shredermann-hash/MoodiMOS/english/cad/MoodiMOS_Robot/screens/face.png

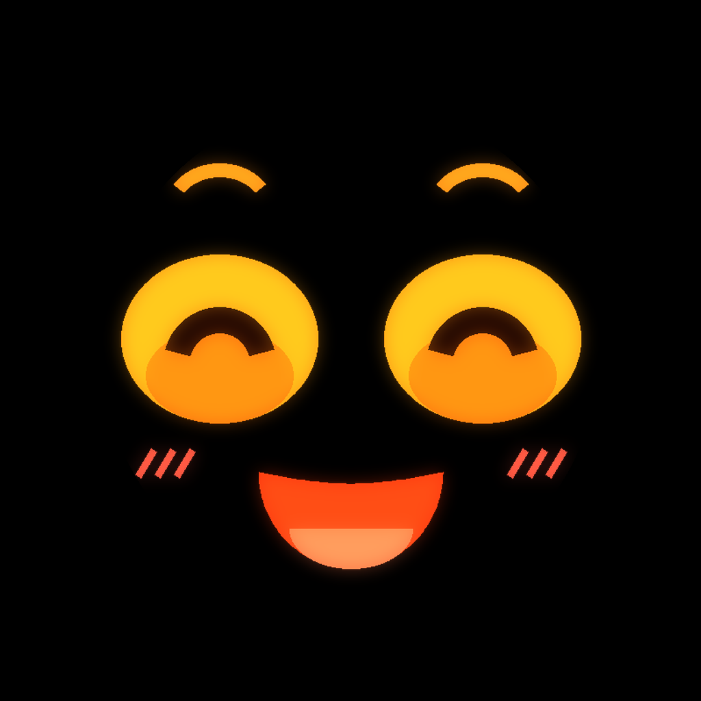
english/cad/MoodiMOS_Robot/screens/face.png
