shredermann-hash/MoodiMOS/english/cad/MoodiMOS_Robot/screens/torso.png

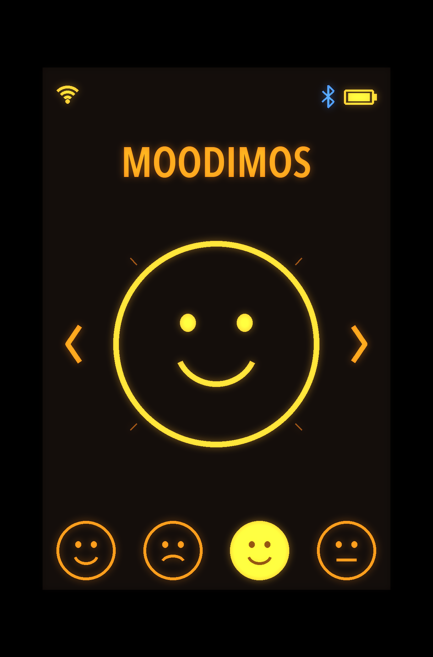
english/cad/MoodiMOS_Robot/screens/torso.png
