shredermann-hash/MoodiMOS/english/extras/dashboard.png

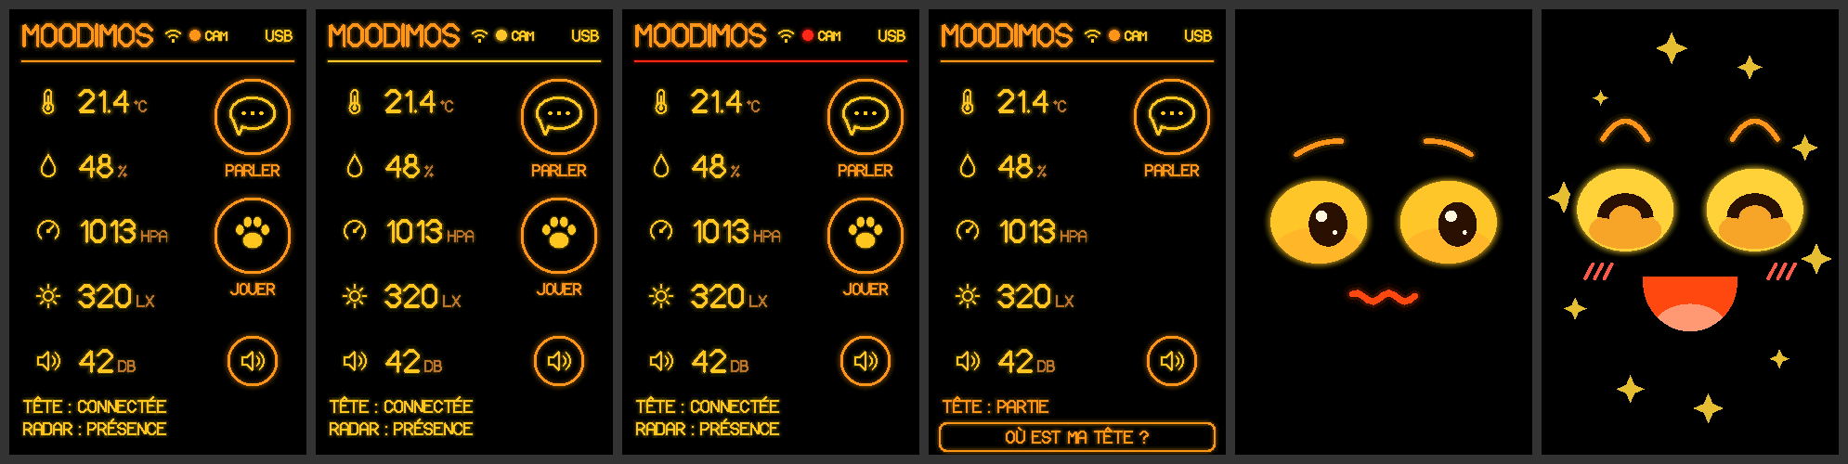
english/extras/dashboard.png
