shredermann-hash/MoodiMOS/english/extras/dial.png

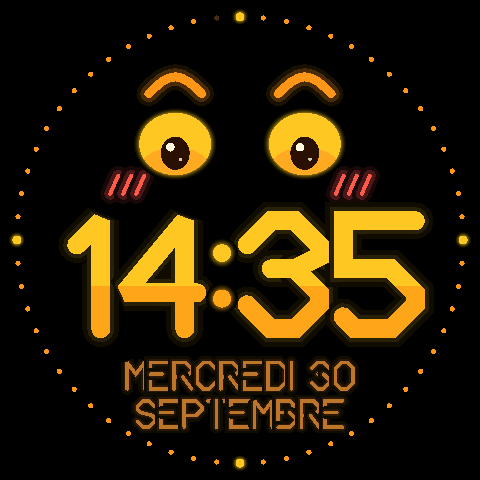
english/extras/dial.png
