shredermann-hash/MoodiMOS/english/extras/neon_face.png

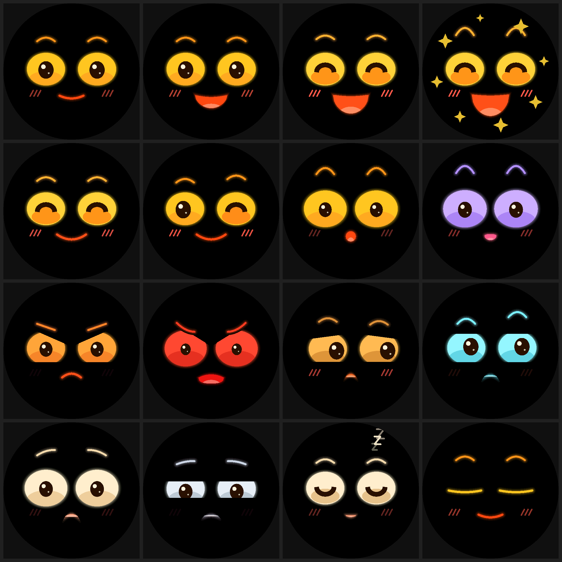
english/extras/neon_face.png
