shredermann-hash/MoodiMOS/english/extras/timer.png

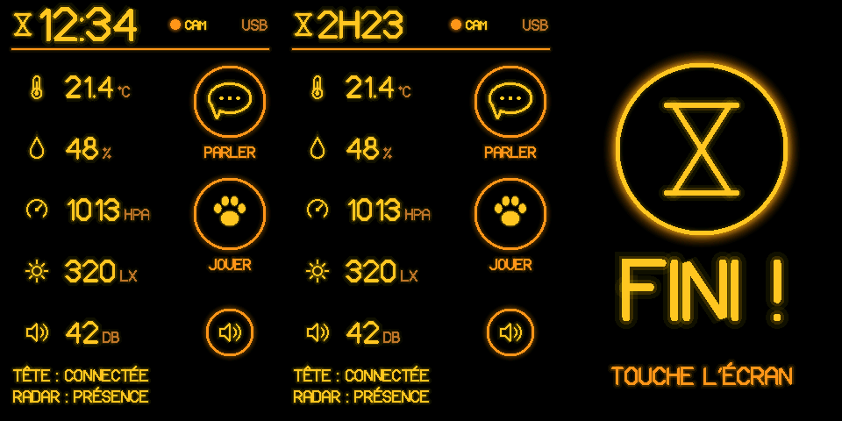
english/extras/timer.png
