shredermann-hash/MoodiMOS/english/extras/who_is_speaking.png

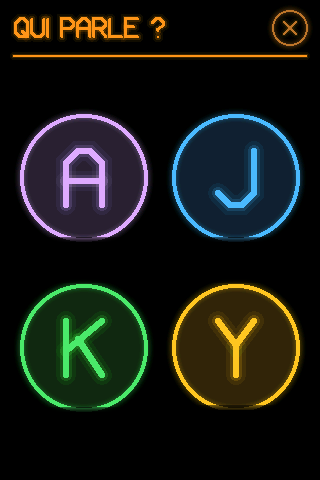
english/extras/who_is_speaking.png
