shredermann-hash/MoodiMOS/english/illustrations/design_head.png

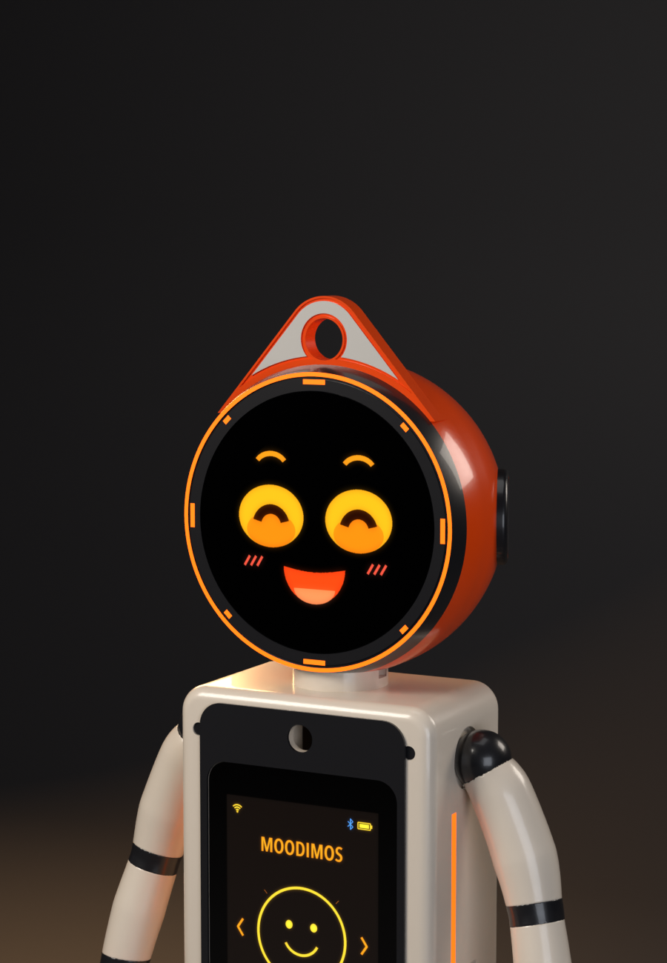
english/illustrations/design_head.png
