shredermann-hash/MoodiMOS/english/illustrations/preview_en_clock.png

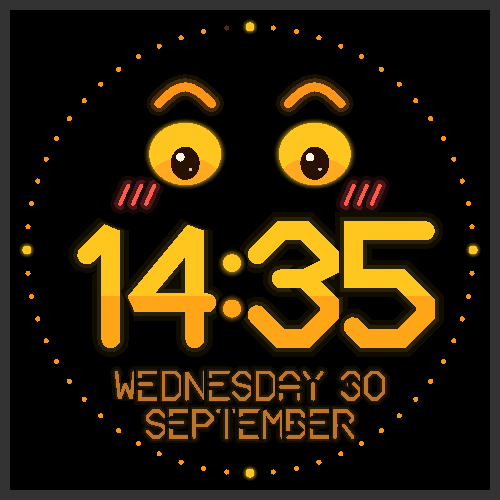
english/illustrations/preview_en_clock.png
