shredermann-hash/MoodiMOS/english/illustrations/preview_en_torso.png

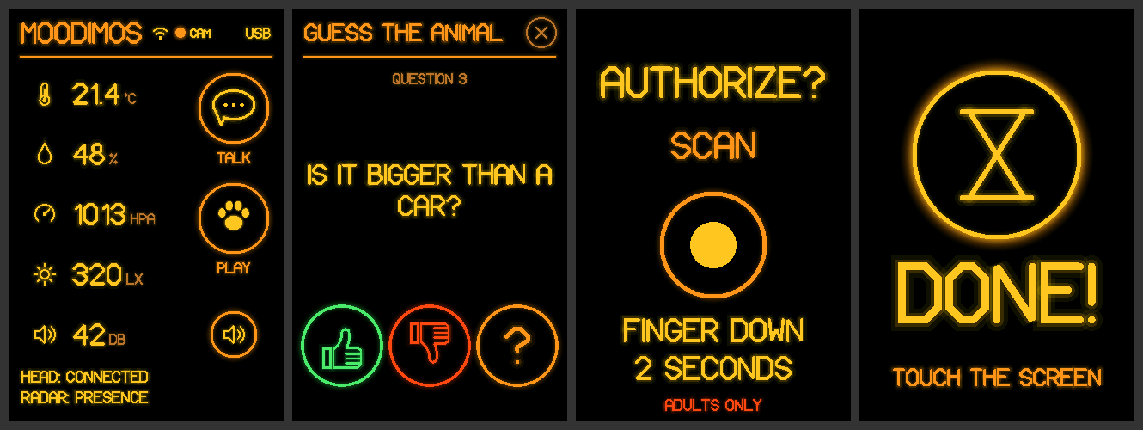
english/illustrations/preview_en_torso.png
