shredermann-hash/MoodiMOS/english/cad/MoodiMOS_Organic/print_stl/pogo_gauge.stl

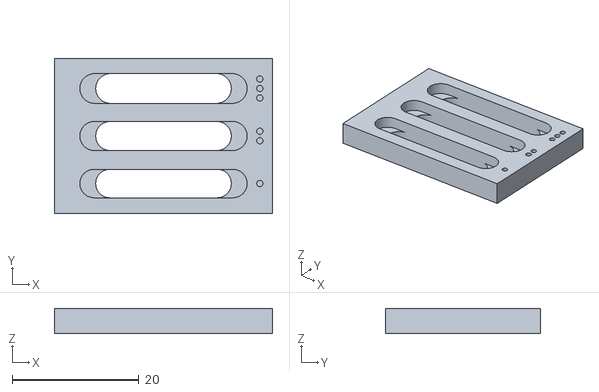
[picture p12: CAD file, 2026-11-03]
english/cad/MoodiMOS_Organic/print_stl/pogo_gauge.stl
34.4 x 24.5 x 4.00
