shredermann-hash/MoodiMOS/english/cad/MoodiMOS_Robot/print_stl/bezel_side_mask.stl

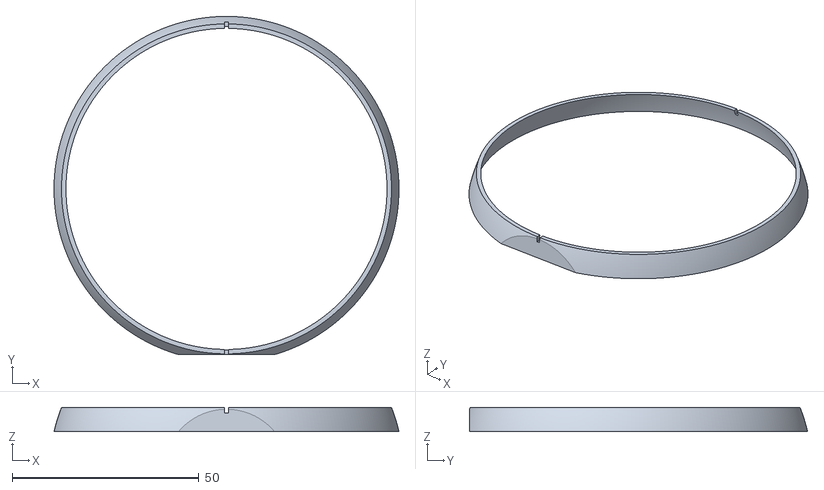
[picture p13: CAD file, 2026-11-03]
english/cad/MoodiMOS_Robot/print_stl/bezel_side_mask.stl
92.4 x 90.6 x 6.50
