shredermann-hash/MoodiMOS/francais/cao/MoodiMOS_Robot/stl_impression/pochoir_index_lunette.stl

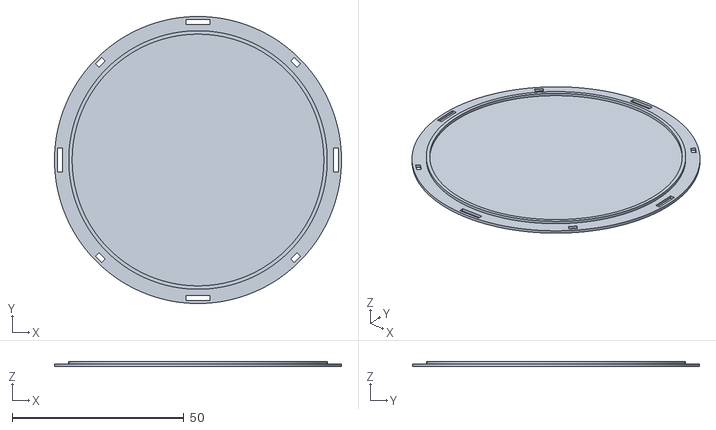
[picture p14: CAD file, 2026-11-03]
francais/cao/MoodiMOS_Robot/stl_impression/pochoir_index_lunette.stl
83.6 x 83.6 x 1.60
