shredermann-hash/MoodiMOS/english/cad/MoodiMOS_Robot/print_stl/glove_cuff_left.stl

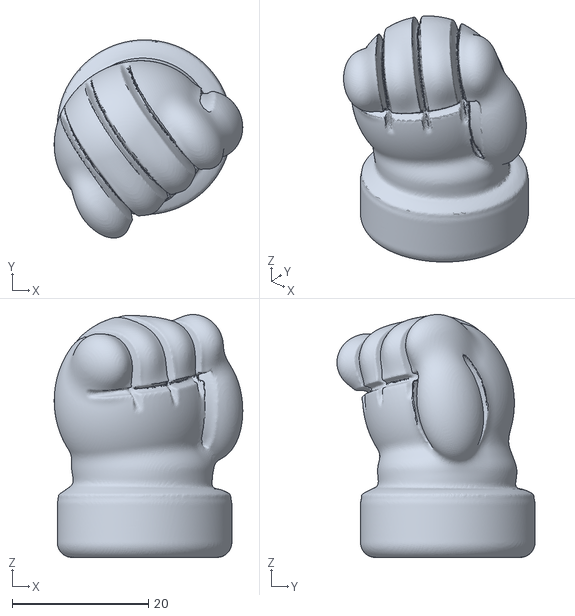
[picture p15: CAD file, 2026-11-03]
english/cad/MoodiMOS_Robot/print_stl/glove_cuff_left.stl
27.6 x 29.0 x 35.6
