shredermann-hash/MoodiMOS/francais/cao/MoodiMOS_Robot/stl_impression/bras_gauche.stl

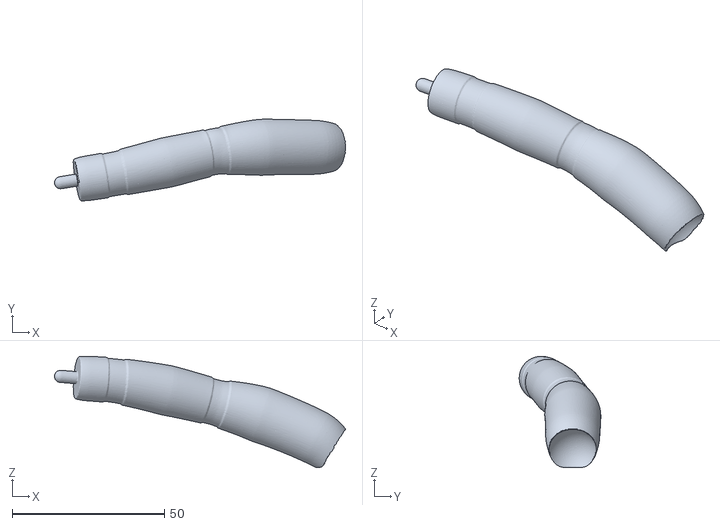
[picture p16: CAD file, 2026-11-03]
francais/cao/MoodiMOS_Robot/stl_impression/bras_gauche.stl
95.7 x 26.8 x 36.6
