shredermann-hash/MoodiMOS/english/cad/MoodiMOS_Robot/print_stl/base.stl

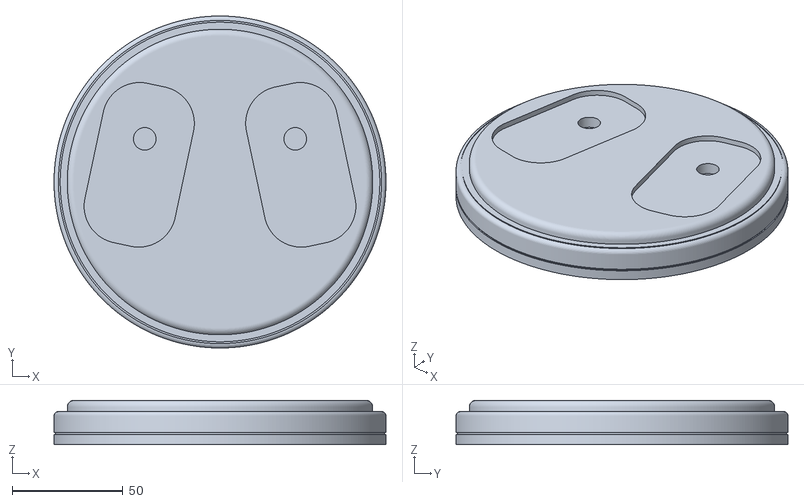
[picture p17: CAD file, 2026-11-03]
english/cad/MoodiMOS_Robot/print_stl/base.stl
150.0 x 150.0 x 20.0
