shredermann-hash/MoodiMOS/francais/cao/MoodiMOS_Robot/stl_impression/torse_cadre.stl

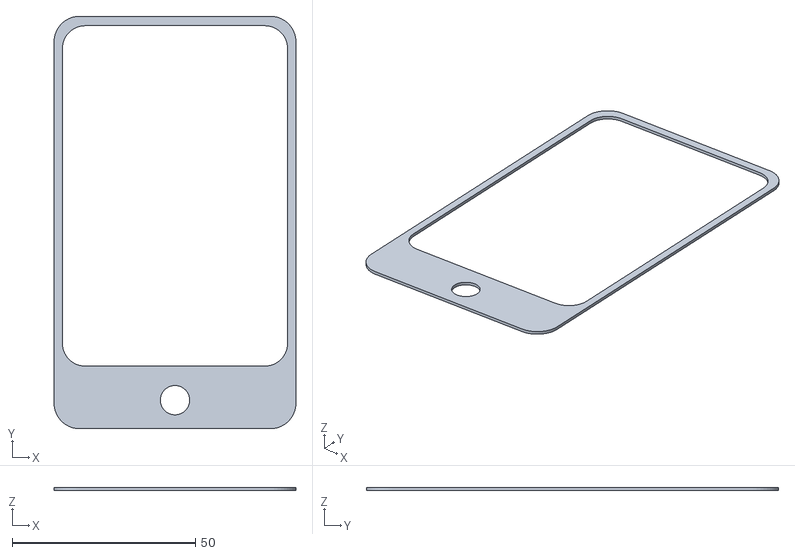
[picture p18: CAD file, 2026-11-03]
francais/cao/MoodiMOS_Robot/stl_impression/torse_cadre.stl
66.0 x 112.5 x 0.85
