shredermann-hash/MoodiMOS/english/cad/MoodiMOS_Robot/print_stl/torso_speaker_box.stl

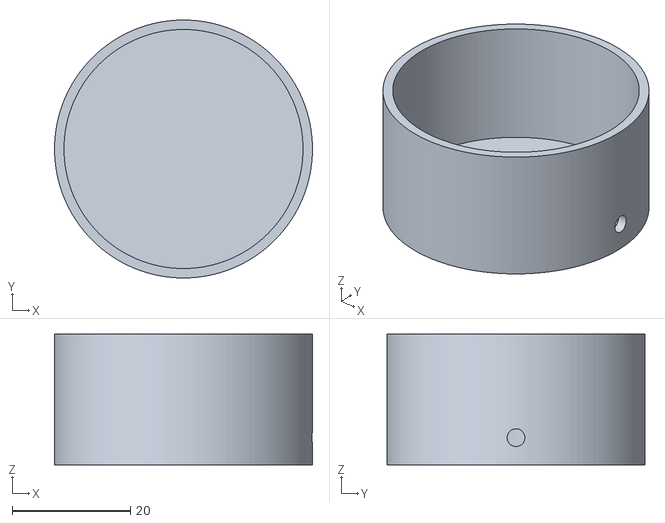
[picture p19: CAD file, 2026-11-03]
english/cad/MoodiMOS_Robot/print_stl/torso_speaker_box.stl
43.6 x 43.6 x 22.1
