shredermann-hash/MoodiMOS/english/cad/MoodiMOS_Robot/print_stl/torso_back.stl

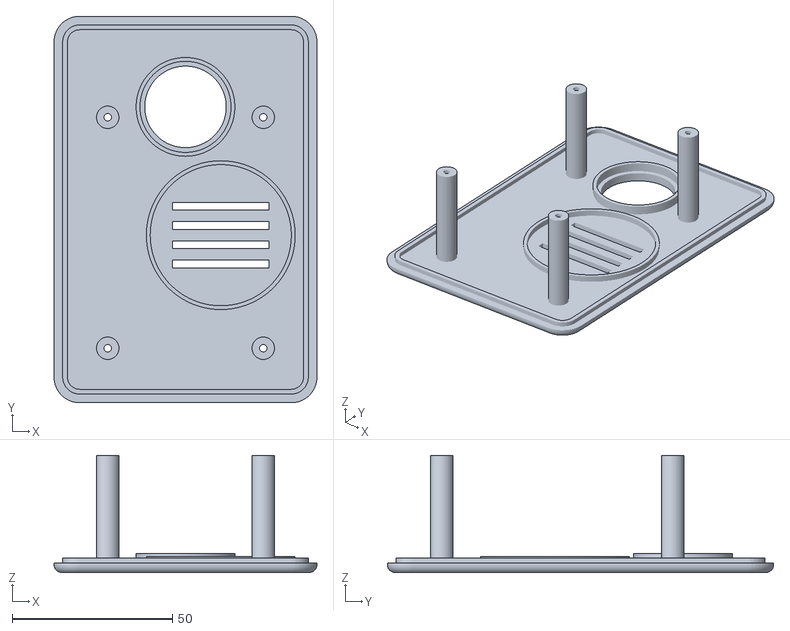
[picture p20: CAD file, 2026-11-03]
english/cad/MoodiMOS_Robot/print_stl/torso_back.stl
82.0 x 120.5 x 36.5
