shredermann-hash/MoodiMOS/francais/cao/MoodiMOS_Robot/stl_impression/epaule_gauche.stl

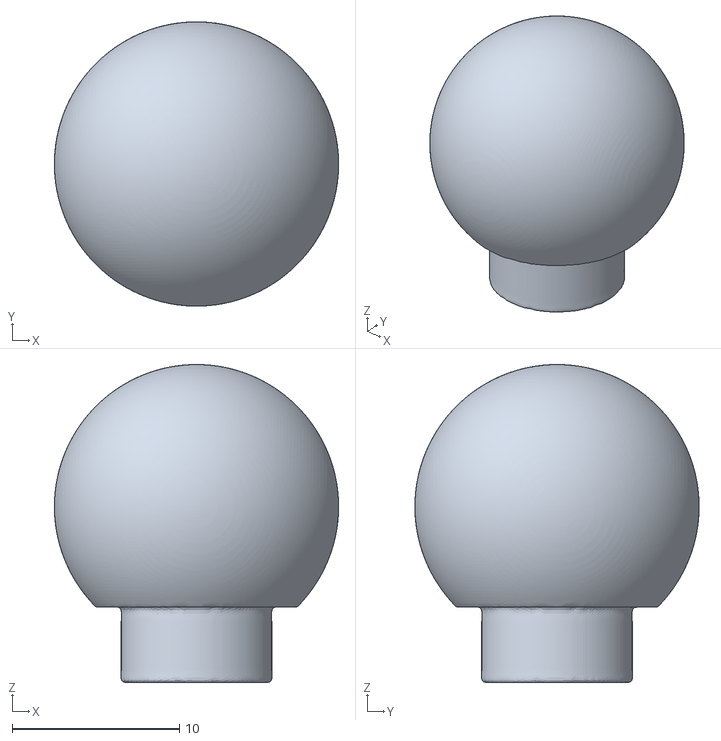
[picture p21: CAD file, 2026-11-03]
francais/cao/MoodiMOS_Robot/stl_impression/epaule_gauche.stl
17.0 x 17.0 x 19.0
