shredermann-hash/MoodiMOS/english/cad/MoodiMOS_Robot/print_stl/torso_front.stl

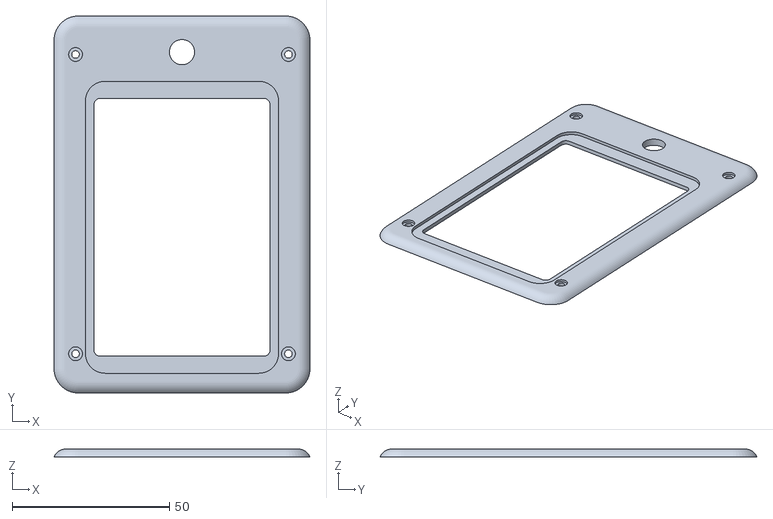
[picture p22: CAD file, 2026-11-03]
english/cad/MoodiMOS_Robot/print_stl/torso_front.stl
81.4 x 119.9 x 2.50
