shredermann-hash/MoodiMOS/francais/cao/MoodiMOS_Robot/stl_impression/tete_dos.stl

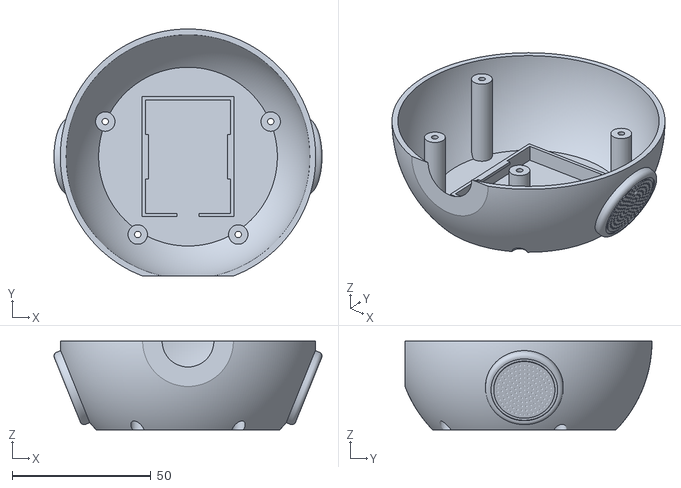
[picture p23: CAD file, 2026-11-03]
francais/cao/MoodiMOS_Robot/stl_impression/tete_dos.stl
96.6 x 89.0 x 32.0
