shredermann-hash/MoodiMOS/francais/cao/MoodiMOS_Robot/stl_impression/tete_plaque.stl

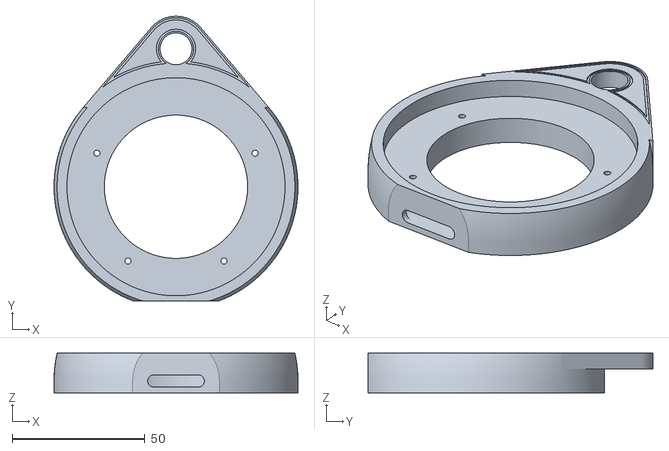
[picture p24: CAD file, 2026-11-03]
francais/cao/MoodiMOS_Robot/stl_impression/tete_plaque.stl
92.0 x 107.3 x 15.0
