shredermann-hash/MoodiMOS/english/cad/MoodiMOS_Robot/print_stl/head_bezel.stl

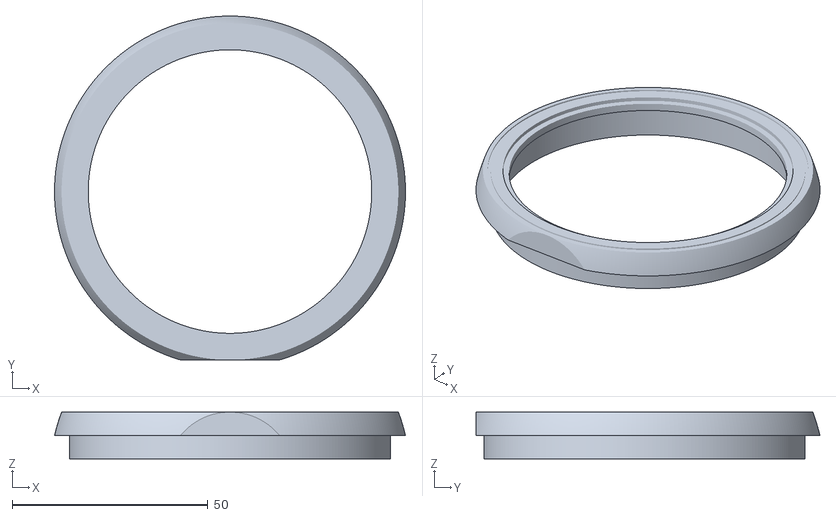
[picture p25: CAD file, 2026-11-03]
english/cad/MoodiMOS_Robot/print_stl/head_bezel.stl
89.6 x 87.8 x 12.0
