shredermann-hash/MoodiMOS/francais/cao/MoodiMOS_Robot/stl_impression/basket_gauche.stl

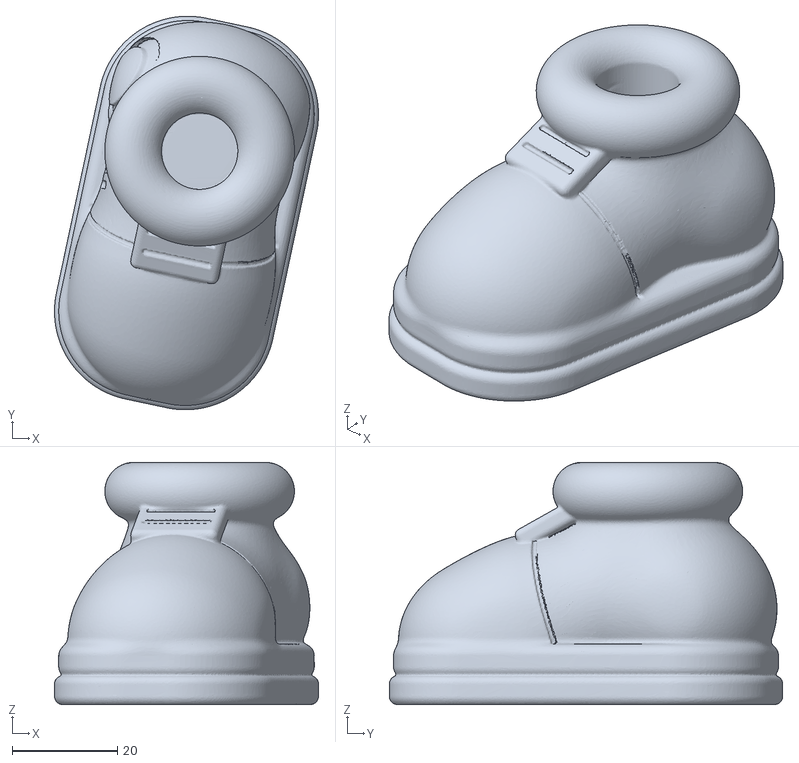
[picture p26: CAD file, 2026-11-03]
francais/cao/MoodiMOS_Robot/stl_impression/basket_gauche.stl
50.1 x 74.7 x 46.0
