shredermann-hash/MoodiMOS/francais/cao/MoodiMOS_Robot/stl_impression/torse_coque.stl

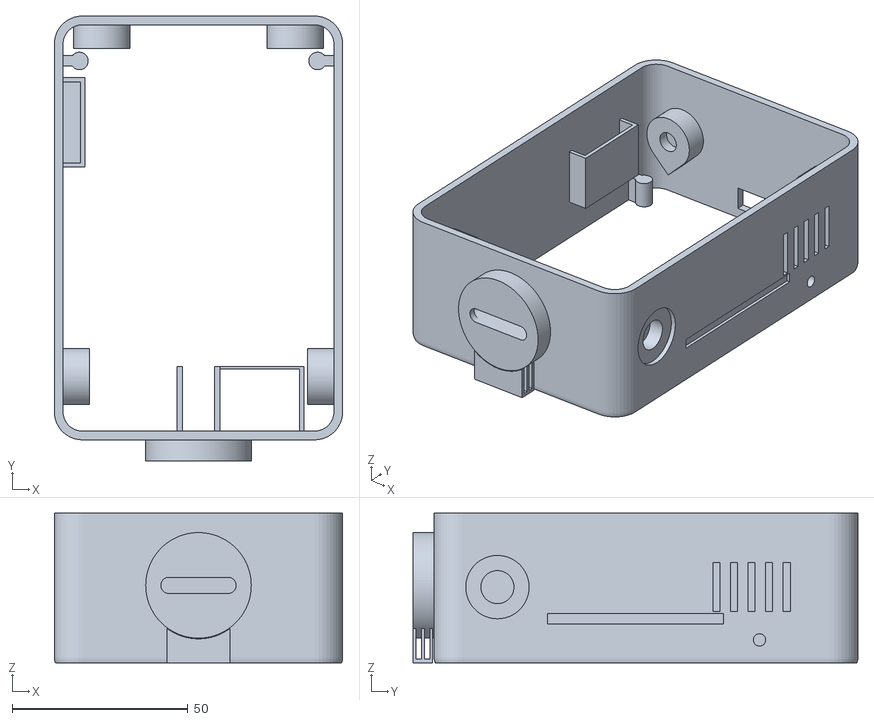
[picture p27: CAD file, 2026-11-03]
francais/cao/MoodiMOS_Robot/stl_impression/torse_coque.stl
82.0 x 126.5 x 42.5
