shredermann-hash/MoodiMOS/english/cad/MoodiMOS_Robot/print_stl/sneaker_magnet_jig_left.stl

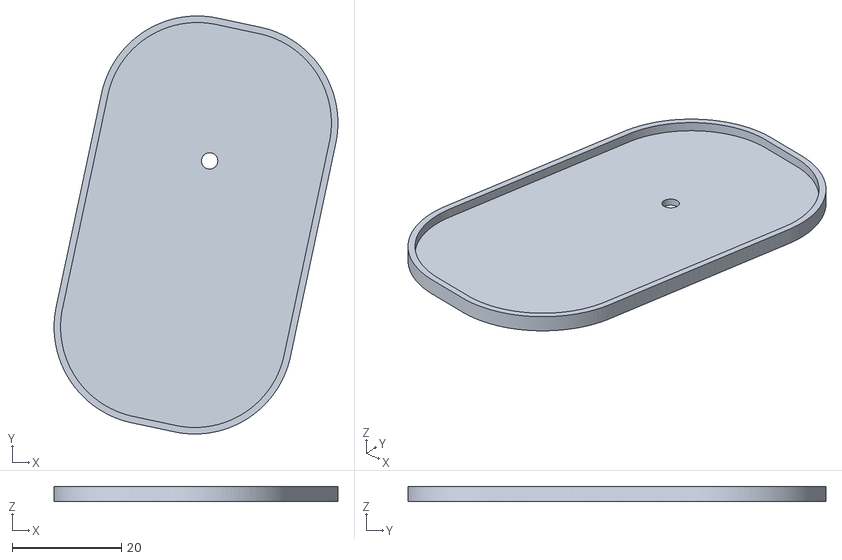
[picture p28: CAD file, 2026-11-03]
english/cad/MoodiMOS_Robot/print_stl/sneaker_magnet_jig_left.stl
52.0 x 76.6 x 2.80
