shredermann-hash/MoodiMOS/francais/cao/MoodiMOS_Robot/stl_impression/jambe_droit.stl

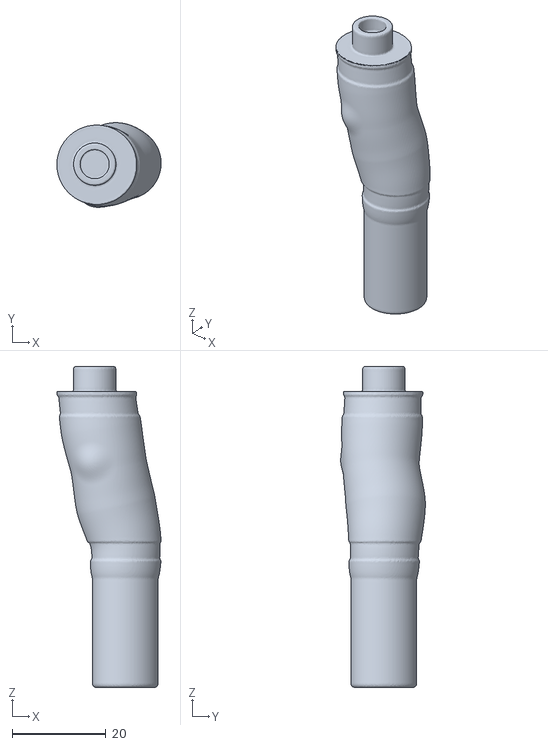
[picture p29: CAD file, 2026-11-03]
francais/cao/MoodiMOS_Robot/stl_impression/jambe_droit.stl
22.2 x 18.0 x 68.4
