shredermann-hash/MoodiMOS/(list of files, cad)

Other CAD files:
english/cad/MoodiMOS_Robot/print_stl/arm_right.stl
english/cad/MoodiMOS_Robot/print_stl/sneaker_right.stl
francais/cao/MoodiMOS_Robot/stl_impression/basket_droit.stl
francais/cao/MoodiMOS_Robot/stl_impression/gabarit_aimant_basket_gauche.stl
francais/cao/MoodiMOS_Robot/stl_impression/socle.stl
francais/cao/MoodiMOS_Robot/stl_impression/jambe_gauche.stl
english/cad/MoodiMOS_Robot/print_stl/glove_cuff_right.stl
francais/cao/MoodiMOS_Robot/stl_impression/epaule_droit.stl
english/cad/MoodiMOS_Robot/print_stl/leg_left.stl
francais/cao/MoodiMOS_Robot/stl_impression/gabarit_aimant_basket_droit.stl
english/cad/MoodiMOS_Robot/print_stl/shoulder_right.stl
francais/cao/MoodiMOS_Robot/stl_impression/bras_droit.stl
english/cad/MoodiMOS_Robot/print_stl/sneaker_magnet_jig_right.stl
francais/cao/MoodiMOS_Robot/stl_impression/gant_bracelet_droit.stl
