shredermann-hash/MoodiMOS/english/diagrams/MoodiMOS_Wiring_neck_pogo.png

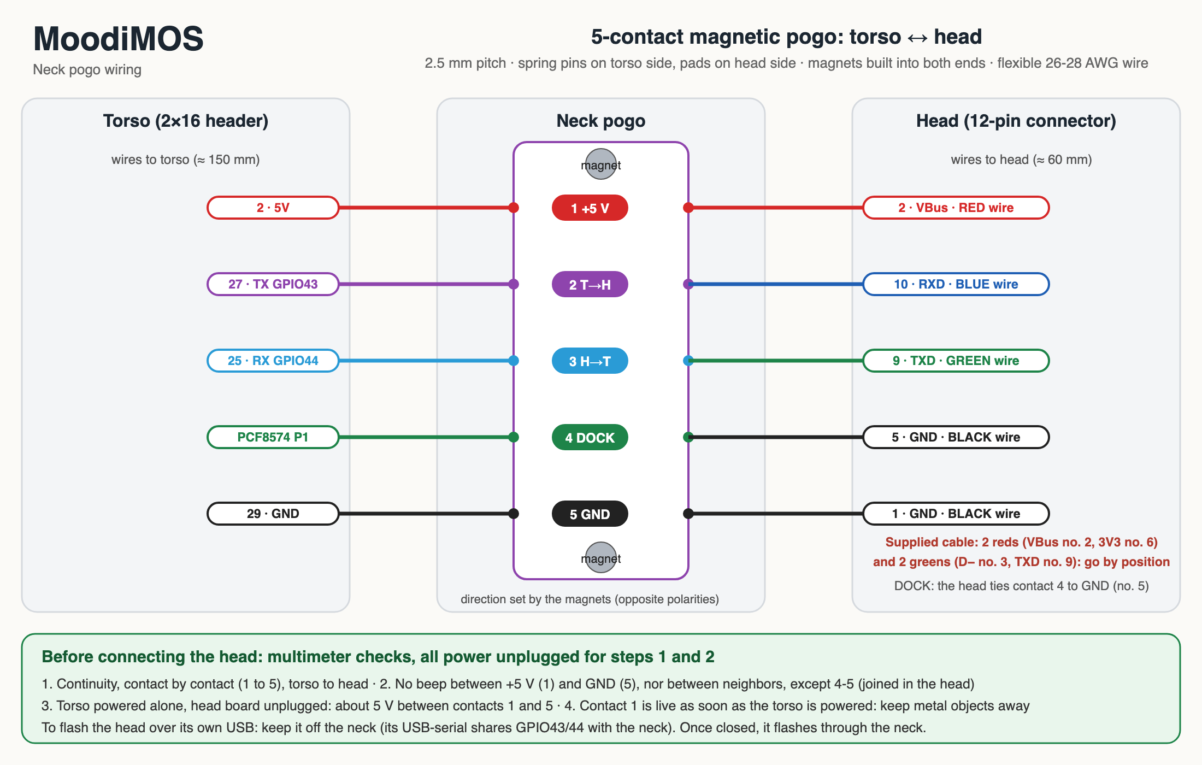
english/diagrams/MoodiMOS_Wiring_neck_pogo.png
