shredermann-hash/MoodiMOS/english/diagrams/MoodiMOS_Wiring_torso_head.png

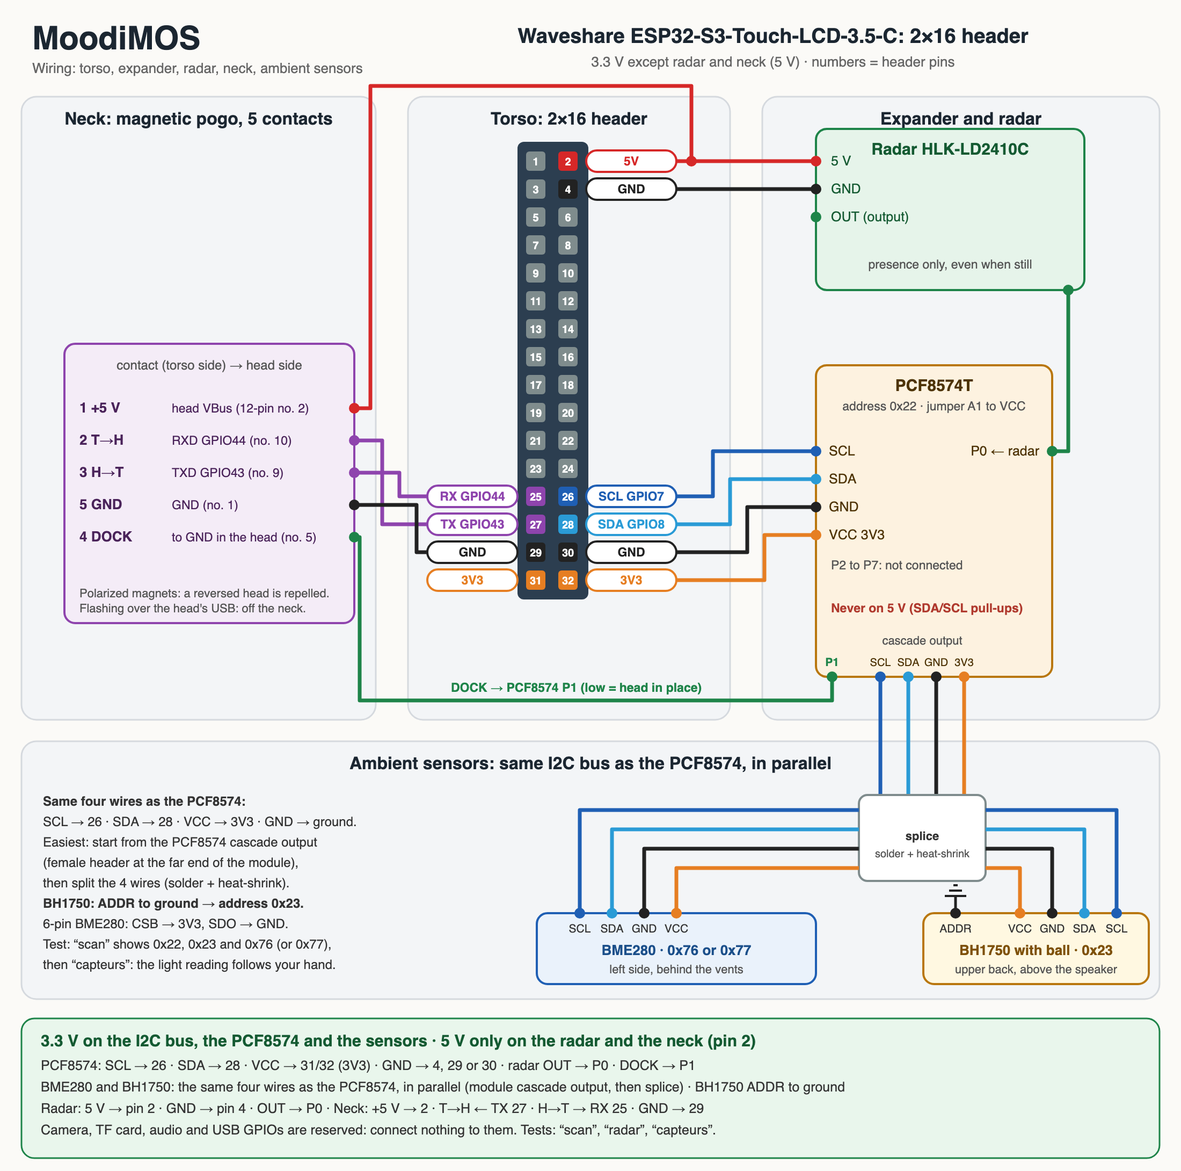
english/diagrams/MoodiMOS_Wiring_torso_head.png
