shredermann-hash/MoodiMOS/english/firmware/moodimos-torso/GuessGame.h

// "Guess the Animal" (complete edition): the child thinks of an animal; the robot guesses by asking questions, responding via the torso screen buttons (yes, no, I don’t know). Pure logic, tested on computer (tests/guess_tests.cpp): the torso loop generates phrases, triggers head expressions, and renders the screen based on outputs.
// 
// GuessEngine: the prototype logic (Mac, extras/guess_animal/guess_animal.py), same probabilities—each response reinforces matching animals without eliminating others (wrong answers don’t invalidate the game). The next question optimally narrows remaining candidates.
// 
// GuessGame: the game mode. Phrases stored in torso flash (devine_intro, devine_q07, devine_a12…), generated by extras/guess_animal/to_robot.py.
#pragma once
#include <math.h>
#include <stdint.h>
#include <stdio.h>
#include <string.h>
#include "GuessData.h"
#include "HeadExpressions.h"

class GuessEngine {
 public:
  enum Answer : uint8_t { YES, NO, DONT_KNOW };
  struct Move { bool propose; uint8_t index; };   // Proposed animal query
  static constexpr double RELIABLE = 0.9;      // a child responds 9 times out of 10
  static constexpr double SURE = 0.8, AHEAD = 8.0;   // proposes a safer design, ahead of the second option.
  static constexpr int MIN_QUESTIONS = 3, MAX_QUESTIONS = 14;

  void start() {
    for (double& p : p_) p = 1.0 / GuessData::ANIMALS;
    asked_ = rejected_ = 0;
    count_ = 0;
  }

  Move next() const {
    int fav = 0;
    for (int i = 1; i < GuessData::ANIMALS; i++)
      if (p_[i] > p_[fav]) fav = i;
    double second = 0;   // second highest probability (equal to the first in case of a tie)
    for (int i = 0; i < GuessData::ANIMALS; i++)
      if (i != fav && p_[i] > second) second = p_[i];
    const int q = bestQuestion();
    const bool ahead = p_[fav] >= SURE || p_[fav] >= AHEAD * second;   // an inconsistent answer should not leave the game looping
    if (q < 0 || count_ >= MAX_QUESTIONS || (ahead && count_ >= MIN_QUESTIONS)) return {true, uint8_t(fav)};
    return {false, uint8_t(q)};
  }

  void answer(uint8_t q, Answer a) {
    if (q >= GuessData::QUESTIONS) return;
    asked_ |= 1ULL << q;
    count_++;
    if (a == DONT_KNOW) return;
    for (int i = 0; i < GuessData::ANIMALS; i++) {
      const double y = yesProb(i, q);
      p_[i] *= a == YES ? y : 1 - y;
    }
    normalize();
  }

  // The robot suggested this animal, which was not it.
  void reject(uint8_t animal) {
    if (animal >= GuessData::ANIMALS) return;
    rejected_ |= 1ULL << animal;
    p_[animal] = 0;
    normalize();
  }

  int asked() const { return count_; }
  double probability(uint8_t animal) const { return animal < GuessData::ANIMALS ? p_[animal] : 0; }

 private:
  // Probability child answers "yes" to question q while thinking of animal a.
  double yesProb(int a, int q) const {
    const GuessData::Animal& an = GuessData::ANIMAL[a];
    double v = an.yes >> q & 1 ? 1.0 : an.maybe >> q & 1 ? 0.5 : 0.0;
    if (GuessData::QUESTION[q].inverse) v = 1 - v;
    return RELIABLE * v + (1 - RELIABLE) * (1 - v);
  }

  static double entropy(const double* p, int n, double scale) {
    double h = 0;
    for (int i = 0; i < n; i++) {
      const double x = p[i] * scale;
      if (x > 0) h -= x * log2(x);
    }
    return h;
  }

  // Information gain maximum; −1 if no useful question remains.
  int bestQuestion() const {
    const int n = GuessData::ANIMALS;
    const double base = entropy(p_, n, 1);
    double gainMax = 0.02;
    int choice = -1;
    double yes[GuessData::ANIMALS], no[GuessData::ANIMALS];
    for (int q = 0; q < GuessData::QUESTIONS; q++) {
      if (asked_ >> q & 1) continue;
      double pYes = 0;
      for (int i = 0; i < n; i++) {
        yes[i] = p_[i] * yesProb(i, q);
        no[i] = p_[i] - yes[i];
        pYes += yes[i];
      }
      if (!(pYes > 0 && pYes < 1)) continue;
      const double gain = base - pYes * entropy(yes, n, 1 / pYes) - (1 - pYes) * entropy(no, n, 1 / (1 - pYes));
      if (gain > gainMax) { choice = q; gainMax = gain; }
    }
    return choice;
  }

  void normalize() {
    double s = 0;
    for (double p : p_) s += p;
    if (s <= 0) {   // No probable animals left: all those not excluded revert to possible.
      for (int i = 0; i < GuessData::ANIMALS; i++) s += p_[i] = rejected_ >> i & 1 ? 0 : 1;
      if (s <= 0) { start(); return; }
    }
    for (double& p : p_) p /= s;
  }

  double p_[GuessData::ANIMALS] = {};
  uint64_t asked_ = 0, rejected_ = 0;
  int count_ = 0;
};

class GuessGame {
 public:
  using Answer = GuessEngine::Answer;
  static constexpr int TRIES = 3;                  // Three animals proposed at most
  static constexpr uint32_t WAIT_MS = 15000;       // No response: question repeated.
  static constexpr int REPEATS = 2;                // He abandoned and sulked: she left the game unfinished.
  static constexpr uint32_t THINK_MS = 700;        // a brief pause between two questions
  static constexpr uint32_t SILENT_MS = 800;       // Unheard phrase (missing file): proceed.
  static constexpr uint32_t PRESSED_MS = 400;      // Button lit after pressing

  bool active() const { return st_ != St::Off; }
  // Active response buttons (otherwise shown as off)
  bool buttons() const { return st_ == St::Ask || st_ == St::Propose || st_ == St::Replay; }
  int8_t pressed(uint32_t now) const { return pressedAt_ && since(now, pressedAt_) < PRESSED_MS ? pressed_ : -1; }
  uint8_t round() const { return st_ == St::Ask || st_ == St::Pause ? uint8_t(engine_.asked() + (st_ == St::Ask)) : 0; }
  const char* text() const { return text_; }
  uint32_t revision() const { return revision_; }   // Change on every visible screen update.

  void start(uint32_t now) {
    engine_.start();
    tries_ = 0;
    pressedAt_ = doneAt_ = 0;   // nothing of the front section (a button left "pressed" for days later)
    say("devine_intro", St::Intro, now);
    show("PENSE TRÈS FORT À UN ANIMAL !");
  }

  void quit() {
    if (!active()) return;
    st_ = St::Off;
    stop_ = true;
    phrase_[0] = 0;
    revision_++;
  }

  void press(Answer a, uint32_t now) {
    if (!buttons()) return;
    pressed_ = int8_t(a);
    pressedAt_ = now | 1;
    revision_++;
    switch (st_) {
      case St::Ask:
        engine_.answer(question_, a);
        expression(HeadExpressions::PERPLEXE, 10);   // *reflects*
        stop_ = true;                                // The current question is incomplete.
        st_ = St::Pause;
        pauseUntil_ = now + THINK_MS;
        break;
      case St::Propose:
        if (a == Answer::YES) {
          expression(HeadExpressions::JOIE, 40);
          say("devine_youpi", St::Won, now);
          show("YOUPI ! J'AI DEVINÉ !");
        } else if (a == Answer::NO) {
          engine_.reject(animal_);
          if (tries_ < TRIES) {
            expression(HeadExpressions::SURPRIS, 15);
            say("devine_encore", St::Again, now);
            show("OH ! JE RÉFLÉCHIS ENCORE...");
          } else {
            expression(HeadExpressions::RIEUR, 40);
            say("devine_bravo", St::Lost, now);
            show("BRAVO, TU M'AS BATTU !");
          }
        } else {
          sayAgain(now);   // Uncertainty prompt: *"Is it a cat?"* → repeats query
        }
        break;
      case St::Replay:
        if (a == Answer::YES) {
          engine_.start();
          tries_ = 0;
          say("devine_go", St::Go, now);
          show("ON Y VA !");
        } else {
          bye(now);
        }
        break;
      default:
        break;
    }
  }

  void update(uint32_t now, bool speaking) {
    if (!active()) return;
    if (pressedAt_ && since(now, pressedAt_) >= PRESSED_MS) { pressedAt_ = 0; revision_++; }
    if (speaking) heard_ = true;
    const bool done = !phrase_[0] && ((heard_ && !speaking) || (!heard_ && since(now, saidAt_) >= SILENT_MS));
    if (done && !doneAt_) doneAt_ = now | 1;
    switch (st_) {
      case St::Intro:
        if (done) { say("devine_go", St::Go, now); show("ON Y VA !"); }
        break;
      case St::Go:
      case St::Again:
        if (done) move(now);
        break;
      case St::Pause:
        if (int32_t(now - pauseUntil_) >= 0) move(now);
        break;
      case St::Won:
      case St::Lost:
        if (done) { say("devine_rejoue", St::Replay, now); show("ON REJOUE ?"); }
        break;
      case St::Ask:
      case St::Propose:
      case St::Replay:
        if (doneAt_ && since(now, doneAt_) >= WAIT_MS) {
          if (st_ == St::Replay) bye(now);                 // Finished part, no response: goodbye
          else if (repeats_ >= REPEATS) abandon();         // unfinished section: sulks, silent
          else { repeats_++; sayAgain(now); }
        }
        break;
      case St::Bye:
        if (done) { st_ = St::Off; revision_++; }
        break;
      case St::Off:
        break;
    }
  }

  // What the loop should now perform (each request is returned only once).
  const char* takePhrase(char* out, size_t size) {
    if (!phrase_[0]) return nullptr;
    snprintf(out, size, "%s", phrase_);
    phrase_[0] = 0;
    return out;
  }
  bool takeStop() { bool s = stop_; stop_ = false; return s; }
  bool takeSulk() { bool s = sulk_; sulk_ = false; return s; }   // abandoned part: the head is sulking
  bool takeExpression(uint8_t& expr, uint8_t& tenths) {
    if (!exprPending_) return false;
    exprPending_ = false;
    expr = expr_;
    tenths = tenths_;
    return true;
  }

  const GuessEngine& engine() const { return engine_; }
  int tries() const { return tries_; }
  uint8_t question() const { return question_; }
  uint8_t animal() const { return animal_; }

 private:
  enum class St : uint8_t { Off, Intro, Go, Ask, Pause, Propose, Again, Won, Lost, Replay, Bye };

  // Elapsed time since t; 0 if t is a marked instant marked « | 1 » exactly in the future.
  static uint32_t since(uint32_t now, uint32_t t) { return int32_t(now - t) > 0 ? now - t : 0; }

  void say(const char* name, St next, uint32_t now) {
    snprintf(phrase_, sizeof(phrase_), "%s", name);
    st_ = next;
    saidAt_ = now;
    heard_ = false;
    doneAt_ = 0;
    revision_++;
  }

  void sayAgain(uint32_t now) {
    char name[sizeof(phrase_)];
    if (st_ == St::Ask) snprintf(name, sizeof(name), "devine_q%02d", question_);
    else if (st_ == St::Propose) snprintf(name, sizeof(name), "devine_a%02d", animal_);
    else snprintf(name, sizeof(name), "devine_rejoue");
    say(name, st_, now);
  }

  void move(uint32_t now) {
    const GuessEngine::Move m = engine_.next();
    char name[sizeof(phrase_)];
    repeats_ = 0;
    if (m.propose) {
      tries_++;
      animal_ = m.index;
      snprintf(name, sizeof(name), "devine_a%02d", animal_);
      expression(HeadExpressions::CONTENT, 20);   // not EMBALLE: on the head, that is the red anger
      say(name, St::Propose, now);
      snprintf(text_, sizeof(text_), "C'EST %s ?", GuessData::ANIMAL[animal_].name);
    } else {
      question_ = m.index;
      snprintf(name, sizeof(name), "devine_q%02d", question_);
      expression(HeadExpressions::CURIEUX, 30);
      say(name, St::Ask, now);
      show(GuessData::QUESTION[question_].text);
    }
  }

  void bye(uint32_t now) {
    expression(HeadExpressions::CLIN, 20);
    say("devine_bientot", St::Bye, now);
    show("À BIENTÔT !");
  }

  void abandon() {
    st_ = St::Off;
    sulk_ = true;
    revision_++;
  }

  void show(const char* s) { snprintf(text_, sizeof(text_), "%s", s); }
  void expression(uint8_t e, uint8_t tenths) { expr_ = e; tenths_ = tenths; exprPending_ = true; }

  GuessEngine engine_;
  St st_ = St::Off;
  char phrase_[16] = {};
  char text_[96] = {};
  uint32_t saidAt_ = 0, doneAt_ = 0, pauseUntil_ = 0, pressedAt_ = 0, revision_ = 0;
  bool heard_ = false, stop_ = false, exprPending_ = false, sulk_ = false;
  int8_t pressed_ = -1;
  uint8_t question_ = 0, animal_ = 0, expr_ = 0, tenths_ = 0;
  int tries_ = 0, repeats_ = 0;
};
