shredermann-hash/MoodiMOS/english/firmware/moodimos-head/MoodiMOSHead.h

// BLE MoodiMOS protocol — detachable head (pendant/peripheral) ↔ torso (central).
// Reference: handoff §7, study dossier §7.
// Identical copy in `moodimos-torso/` and `moodimos-head/`, verified by tests.
// Standard include guard (not `#pragma once`): both copies may overlap in tests.
#ifndef MOODIMOS_HEAD_H
#define MOODIMOS_HEAD_H
#include <stddef.h>
#include <stdint.h>

#define MOODI_HEAD_SERVICE_UUID "8afd14bb-765a-4f56-a4fa-c07785563060"
#define MOODI_HEAD_RING_UUID    "d348c64e-8819-4f4d-96e3-9aa7bb866c64"   // code: duration × 100 ms, `0` = stop
#define MOODI_HEAD_STATUS_UUID  "eae93874-57a6-493d-88a1-8fec9106c072"   // lecture + notification (audio/visual feedback)
#define MOODI_HEAD_NAME         "MoodiMOS-TETE"

constexpr uint8_t MOODI_UNKNOWN = 255;   // Unmeasured battery or charge level

struct __attribute__((packed)) MoodiHeadStatus {
  uint8_t batteryPct;   // Estimation 0…100, MOODI_UNKNOWN otherwise
  uint8_t charging;     // `0 / 1, MOODI_UNKNOWN else`
  uint8_t expression;   // Head expression
};
static_assert(sizeof(MoodiHeadStatus) == 3, "statut tête : 3 octets");

// The status is also included in the manufacturer’s data sheet: the torso reads it by scanning without connecting. Identifier 0xFFFF (reserved for testing) + "PH" + status.
constexpr uint16_t MOODI_ADV_COMPANY = 0xFFFF;
constexpr size_t MOODI_ADV_LEN = 2 + 2 + sizeof(MoodiHeadStatus);

inline size_t moodiHeadAdvEncode(const MoodiHeadStatus& s, uint8_t out[MOODI_ADV_LEN]) {
  out[0] = MOODI_ADV_COMPANY & 0xFF;
  out[1] = MOODI_ADV_COMPANY >> 8;
  out[2] = 'P';
  out[3] = 'H';
  out[4] = s.batteryPct;
  out[5] = s.charging;
  out[6] = s.expression;
  return MOODI_ADV_LEN;
}

inline bool moodiHeadAdvDecode(const uint8_t* d, size_t n, MoodiHeadStatus& s) {
  if (!d || n != MOODI_ADV_LEN || d[0] != (MOODI_ADV_COMPANY & 0xFF) || d[1] != (MOODI_ADV_COMPANY >> 8) ||
      d[2] != 'P' || d[3] != 'H')
    return false;
  if ((d[4] > 100 && d[4] != MOODI_UNKNOWN) || (d[5] > 1 && d[5] != MOODI_UNKNOWN)) return false;
  s.batteryPct = d[4];
  s.charging = d[5];
  s.expression = d[6];
  return true;
}

#endif  // MOODIMOS_HEAD_H
