shredermann-hash/MoodiMOS/english/firmware/moodimos-head/Qmi8658.h

// IMU QMI8658 (head and torso, address 0x6B): minimal register-based driver.
// **Registers and boot sequence adapted from Waveshare’s *Gyro_QMI8658* examples.**
// Identical copy placed in `moodimos-torso/` and `moodimos-head/`, verified by tests.
#pragma once
#include <Wire.h>

class Qmi8658 {
 public:
  static constexpr uint8_t ADDR = 0x6B;
  static constexpr float ACC_SCALE = 8.0f / 32768.0f;     // ±8 g
  static constexpr float GYRO_SCALE = 512.0f / 32768.0f;  // ±512 °/s

  bool begin(TwoWire& wire) {
    wire_ = &wire;
    uint8_t who = 0;
    if (!read(0x00, &who, 1) || who != 0x05) return false;   // WHO_AM_I
    uint8_t ctrl1 = 0;
    if (!read(0x02, &ctrl1, 1)) return false;
    write(0x02, uint8_t((ctrl1 & 0xFE) | 0x40));   // Active oscillator, address increment
    write(0x03, 0x26);   // Accelerometer ±8 g, 120 Hz
    write(0x04, 0x56);   // gyroscope ±512°/s, 120 Hz
    write(0x08, 0x43);   // Fast clock, active accelerometer, and gyroscope.
    return true;
  }

  // Removed sensors before deep sleep (rebooted via `begin()` on wakeup)
  void powerDown() {
    write(0x08, 0x00);   // Accelerometer and gyroscope disabled
    uint8_t ctrl1 = 0;
    if (read(0x02, &ctrl1, 1)) write(0x02, uint8_t(ctrl1 | 0x01));   // stopped oscillator
  }

  // a → a (as in ASCII),
  // g → °/s (degrees/seconds),
  // reference for the chip.
  bool read(float a[3], float g[3]) {
    uint8_t b[12];
    if (!read(0x35, b, sizeof(b))) return false;
    for (int i = 0; i < 3; i++) {
      a[i] = int16_t(b[2 * i] | (b[2 * i + 1] << 8)) * ACC_SCALE;
      g[i] = int16_t(b[6 + 2 * i] | (b[6 + 2 * i + 1] << 8)) * GYRO_SCALE;
    }
    return true;
  }

 private:
  bool read(uint8_t reg, uint8_t* out, uint8_t n) {
    wire_->beginTransmission(ADDR);
    wire_->write(reg);
    if (wire_->endTransmission(false) != 0) return false;
    if (wire_->requestFrom(ADDR, n) != n) return false;
    for (uint8_t i = 0; i < n; i++) out[i] = wire_->read();
    return true;
  }
  void write(uint8_t reg, uint8_t v) {
    wire_->beginTransmission(ADDR);
    wire_->write(reg);
    wire_->write(v);
    wire_->endTransmission();
  }
  TwoWire* wire_ = nullptr;
};
