shredermann-hash/MoodiMOS/english/firmware/moodimos-torso/HeadFinder.h

// Torso-side 'Where is my head?': the latest status received in BLE advertisements and any pending request to ring the head. Pure, tested logic; HeadLink handles Bluetooth.
#pragma once
#include <stdint.h>
#include "MoodiMOSHead.h"

class HeadFinder {
 public:
  enum Ring : uint8_t { Idle, Pending, Sent, Failed };
  // Deep sleep head mode listens for 1.5 s every 30 s—wait 75 s afterward.
  static constexpr uint32_t RING_TIMEOUT_MS = 75000;
  static constexpr uint32_t RESULT_SHOW_MS = 10000;   // Displayed for 10 seconds: "sent" / "not found"

  void seen(const MoodiHeadStatus& s, uint32_t now) {
    status_ = s;
    seenAt_ = now;
    hasStatus_ = true;
  }

  bool status(uint32_t now, MoodiHeadStatus& s, uint32_t& ageMs) const {
    if (!hasStatus_) return false;
    s = status_;
    ageMs = now - seenAt_;
    return true;
  }

  void forget() { hasStatus_ = false; ring_ = Idle; }   // Head revolves on the neck.

  void requestRing(uint8_t tenths, uint32_t now) {
    if (tenths == 0) return;
    tenths_ = tenths;
    ring_ = Pending;
    ringAt_ = now;
  }

  // Alert waiting? Fails after delay.
  bool wantsRing(uint32_t now) {
    if (ring_ != Pending) return false;
    if (uint32_t(now - ringAt_) >= RING_TIMEOUT_MS) {
      ring_ = Failed;
      ringAt_ = now;
      return false;
    }
    return true;
  }

  void ringSent(uint32_t now) { ring_ = Sent; ringAt_ = now; }

  Ring ring(uint32_t now) {
    wantsRing(now);
    if ((ring_ == Sent || ring_ == Failed) && uint32_t(now - ringAt_) >= RESULT_SHOW_MS) ring_ = Idle;
    return ring_;
  }

  uint8_t ringTenths() const { return tenths_; }

 private:
  MoodiHeadStatus status_ = {MOODI_UNKNOWN, MOODI_UNKNOWN, 0};
  uint32_t seenAt_ = 0, ringAt_ = 0;
  bool hasStatus_ = false;
  Ring ring_ = Idle;
  uint8_t tenths_ = 0;
};
