shredermann-hash/MoodiMOS/(commit log)

2026-11-03 MoodiMOS : dossier de fabrication, en français et en anglais.
    francais/ et english/ contiennent chacun les programmes des deux cartes ESP32-S3, les pièces à imprimer, la CAO et ses générateurs, les scripts Fusion, les schémas de câblage et les outils de conversation facultatifs pour Mac. La notice illustrée est sur Instructables.
    [arm_left.stl, arm_right.stl, base.stl, basket_droit.stl, basket_gauche.stl, bezel_marks_stencil.stl, bezel_side_mask.stl, bras_droit.stl]
2026-11-03 Licence CC BY-NC-SA 4.0 pour tout le dépôt.
    LICENSE à la racine : le texte officiel de Creative Commons. Les trois README la mentionnent : fabriquer, modifier et partager en citant MoodiMOS, sans usage commercial, sous la même licence.
